cbourree/CFM---Mindstorms/Diapo/20151103_113038.jpg

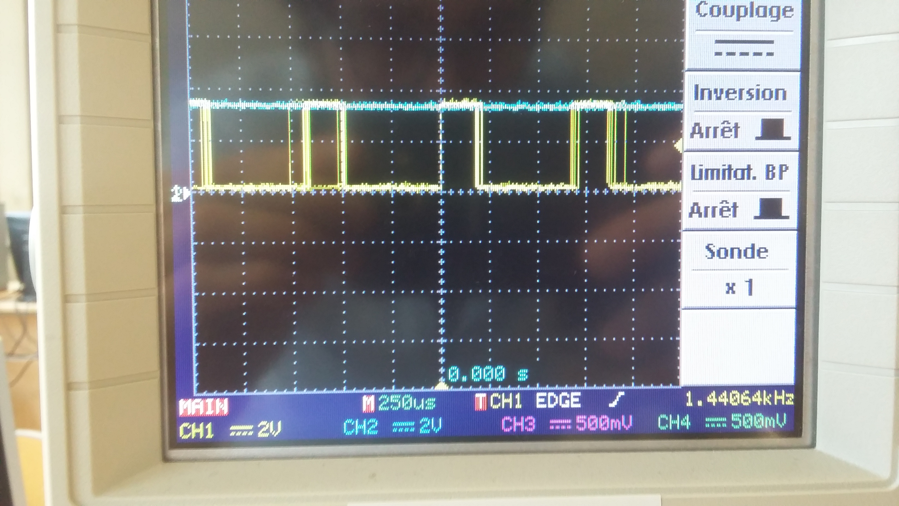
Diapo/20151103_113038.jpg
