cbourree/CFM---Mindstorms/Diapo/3D.png

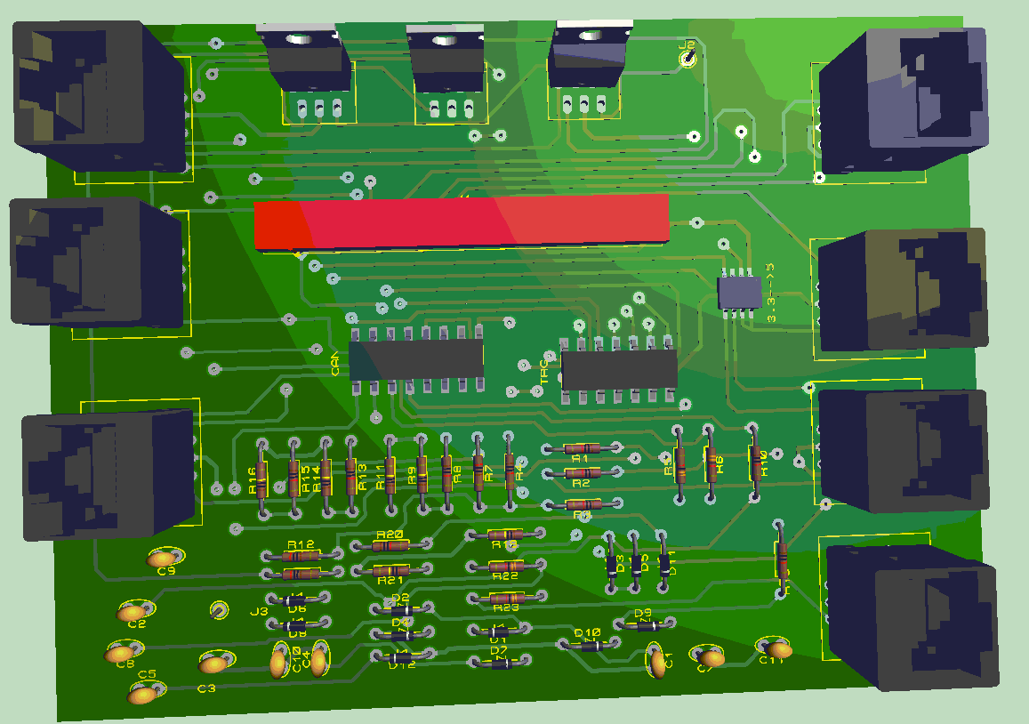
Diapo/3D.png
