cbourree/CFM---Mindstorms/Diapo/Présentaion1.pptx

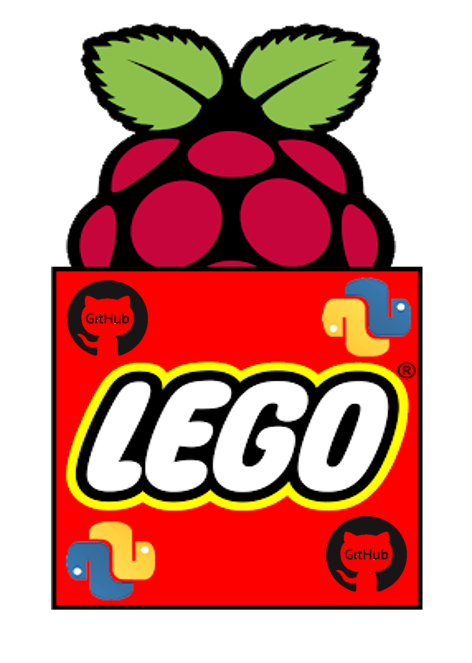
[picture p3: figure]

BERRYSTORM

PROST Maxime
BOURREE Charles ♥
SAGNOL Félix

## Slide 2

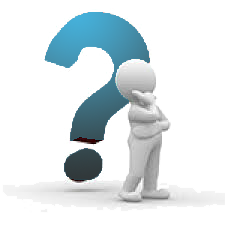
[picture p4: figure]

I – Présentation générale

II – Avancement

## Slide 3

I – Présentation générale

## Slide 4

Objectif

Remplacer le bloc de commande LEGO NXT par une carte programmable en Python fait à base d’une Raspberry PI.
+ Création d’une bibliothèque Python.
+ Faire un petit programme de démonstration.

## Slide 5

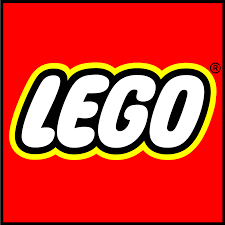
[picture p5: figure]
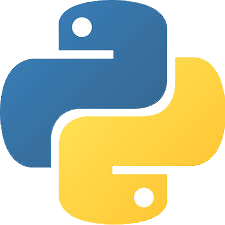
[picture p6: figure]
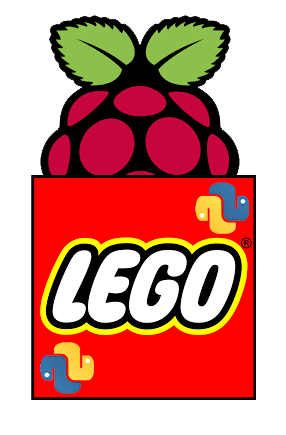
[picture p7: figure]
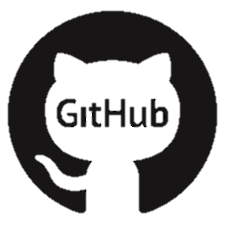
[picture p8: figure]
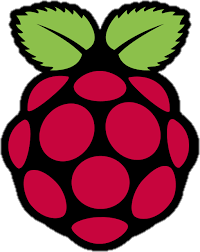
[picture p9: figure]

Outils utilisés

## Slide 6

Synoptique
capteurs digitaux

Raspberry

Réponse
numérique

CAN

Communication

5V

5V

Pont diviseur de tension

Réponse
analogique

Filtre

Réponse
analogique

Capteur digital

## Slide 7

Synoptique capteurs I²C

Raspberry

3,3 V <-> 5V
I²C

I²C

Réponse
numérique

CAN

5V

5V

I²C

Pont diviseur de tension

Réponse
analogique

Filtre

Réponse
analogique

Capteur I²C

## Slide 8

Synoptique moteur

Raspberry

Pont en H

9V

Batterie

Tension de
commande
PWM 3,3V

alimentation

3,3V

9V

Trigger

Moteur + Tachymètre

5V

Protection

5V

## Slide 9

II – Avancement

## Slide 10

GANTT

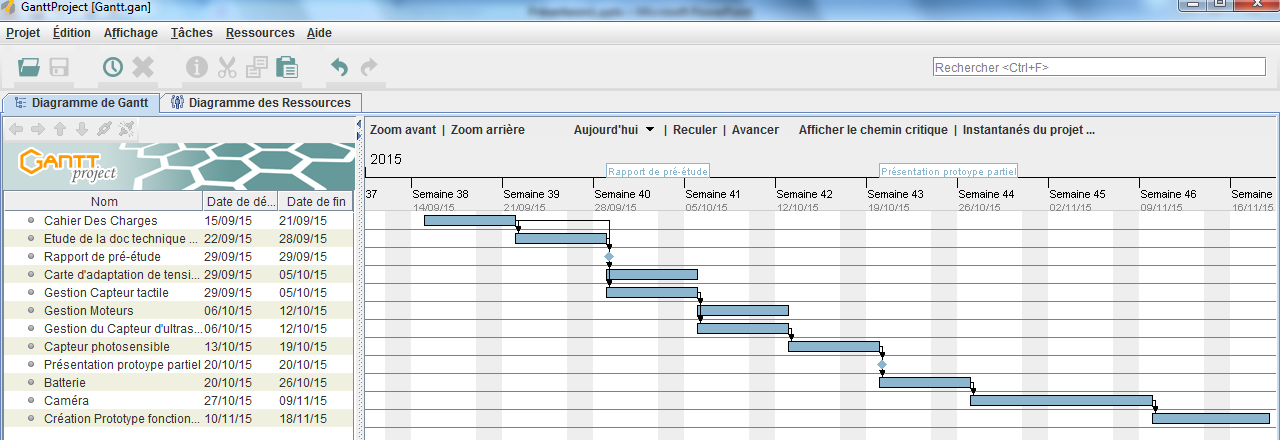
[picture p10: figure]

## Slide 11

FEUILLE DE COURSE

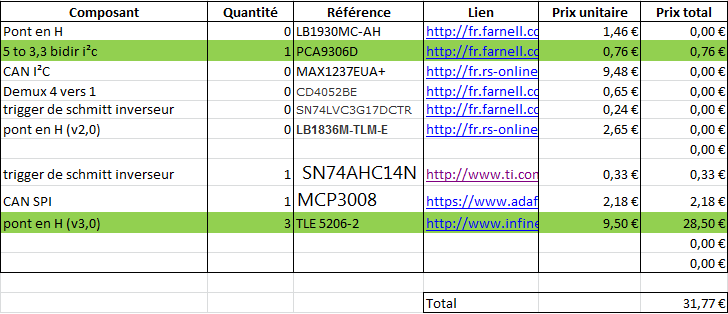
[picture p11: figure]

## Slide 12

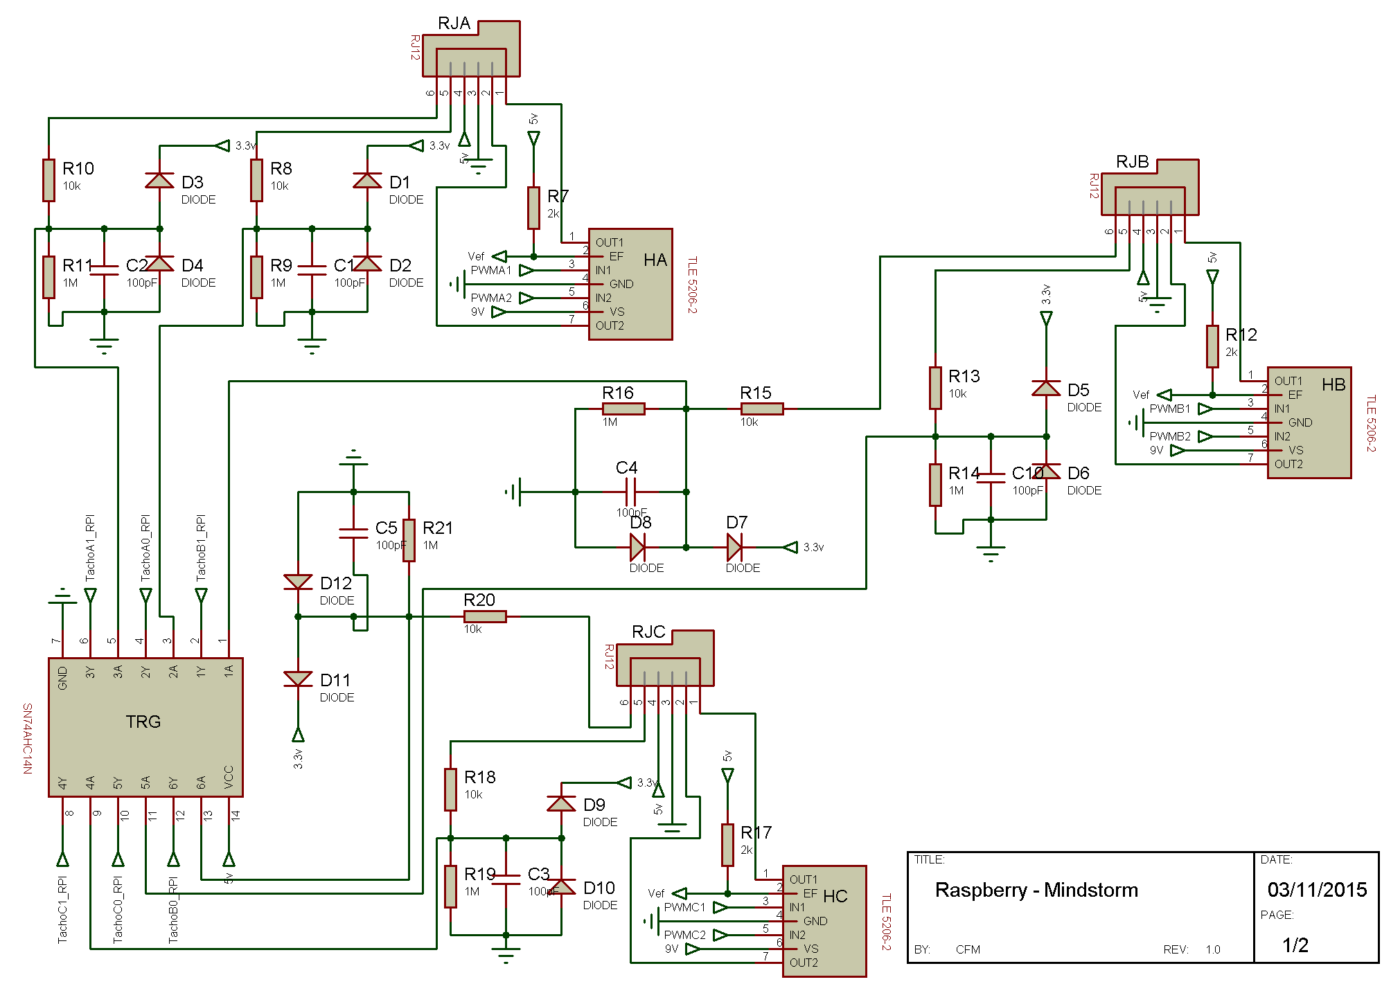
[picture p12: figure]

FEUILLE DE COURSE

## Slide 13

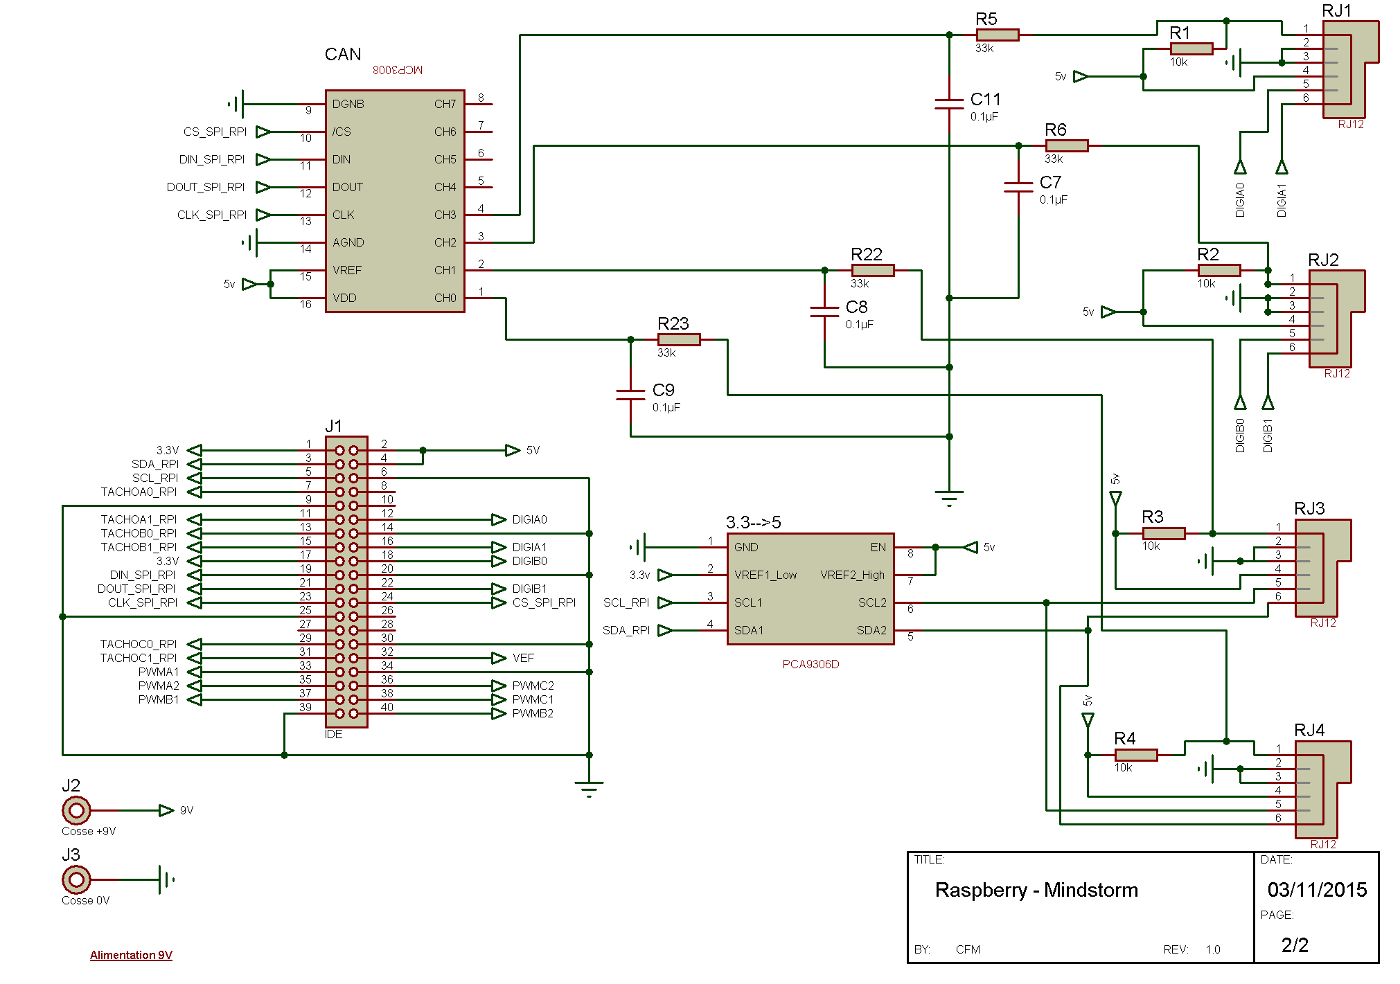
[picture p13: figure]

FEUILLE DE COURSE

## Slide 14

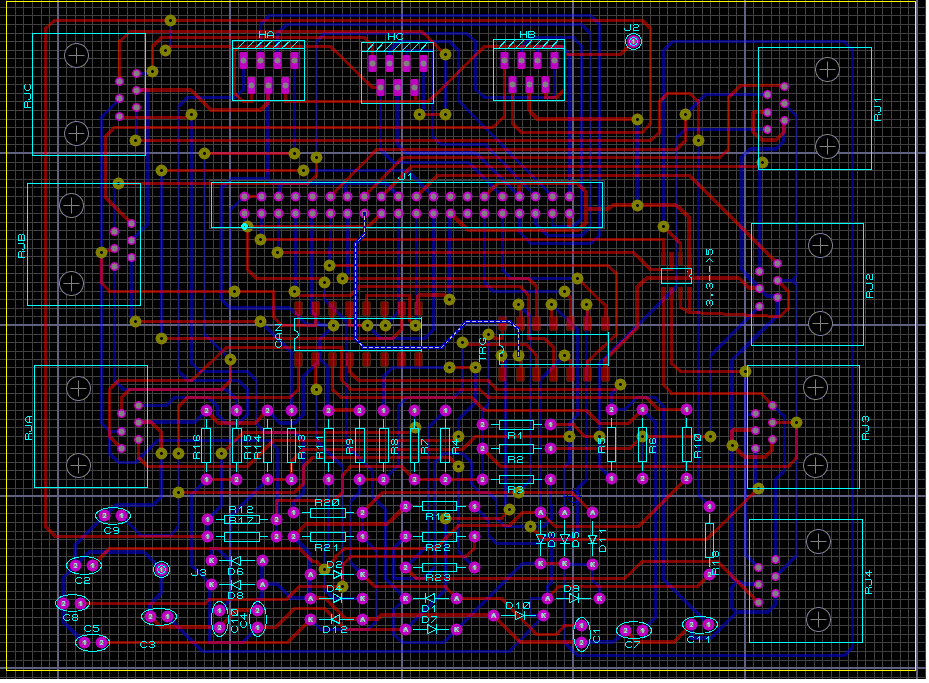
[picture p14: figure]

FEUILLE DE COURSE

## Slide 15


FEUILLE DE COURSE

## Slide 16

Suite des opérations

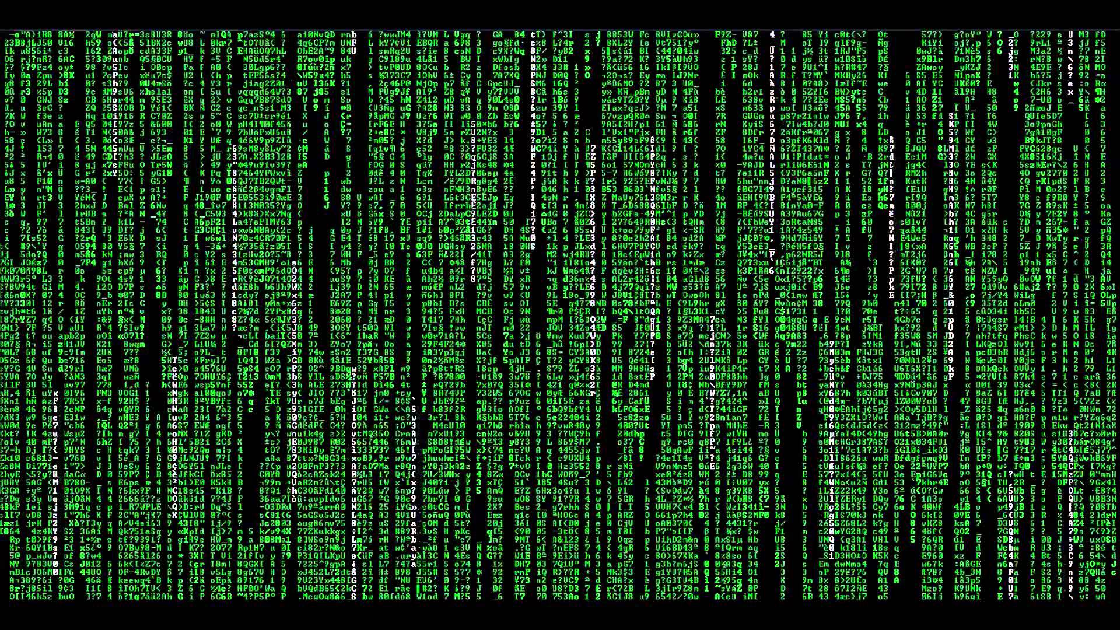
[picture p15: figure]

Programmation de la raspberry PI

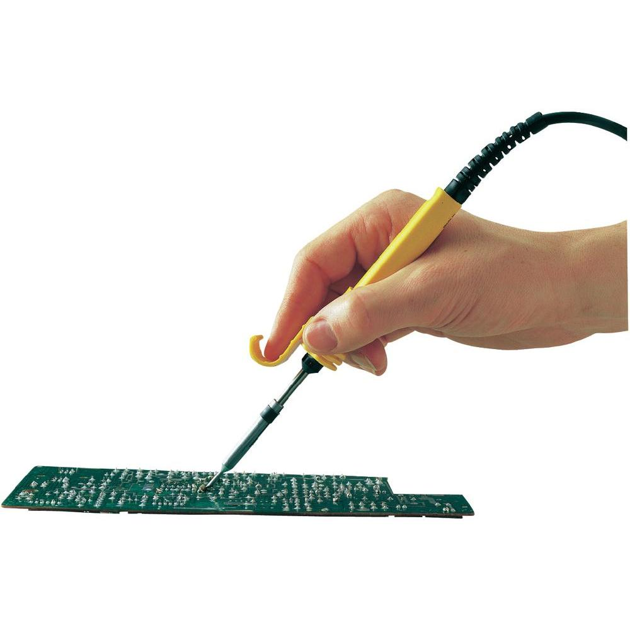
[picture p16: figure]

Soudure de la carte d’interfaçage
