cbourree/CFM---Mindstorms/Presentation/diagramme_charles.docx

Adaptation

Tension

Raspberry PI

Moteurs

Capteurs
