cbourree/CFM---Mindstorms/Presentation/SYNOPTIQUE-special-charles-pdf.pdf

CAPTEURS

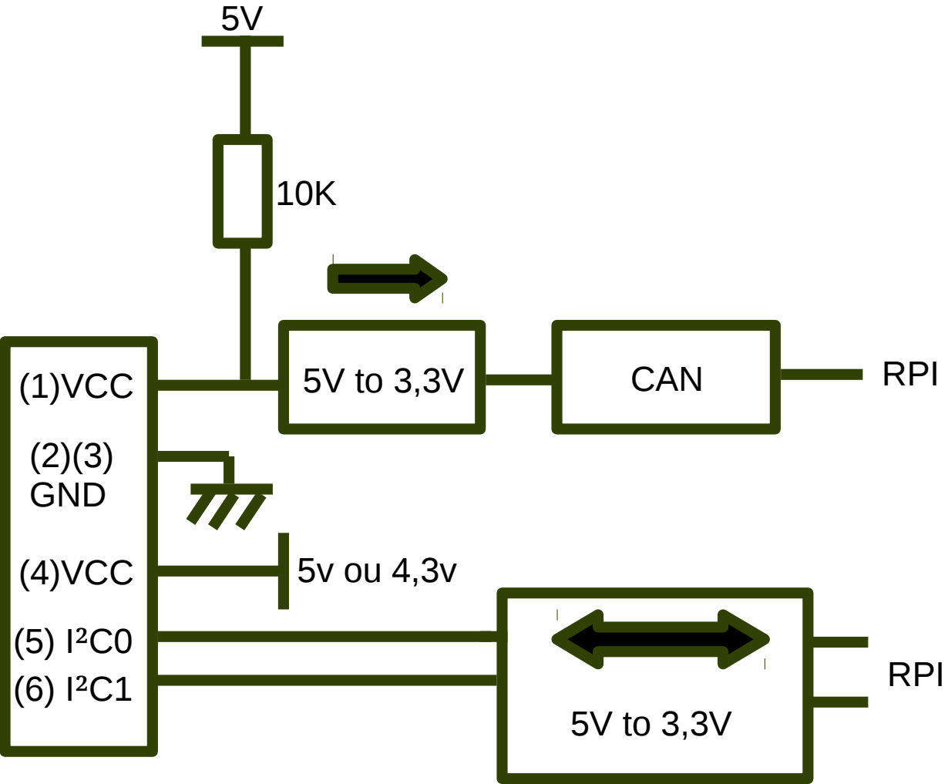
[picture p21: figure]
(1)VCC; (2)(3) GND; (4)VCC; (5) I²C0 (6) I²C1; RPI; CAN
