cbourree/CFM---Mindstorms/Diapo/20151103_113226.jpg

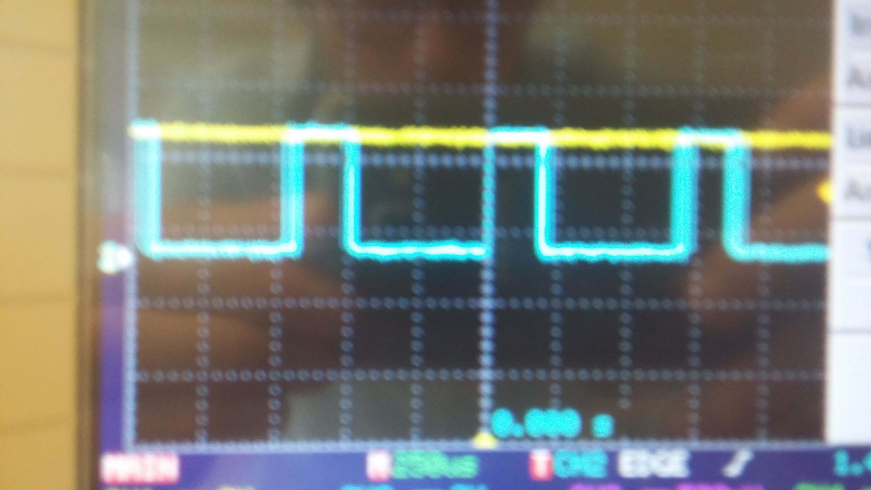
Diapo/20151103_113226.jpg
