cbourree/CFM---Mindstorms/Diapo/avancerpy.PNG

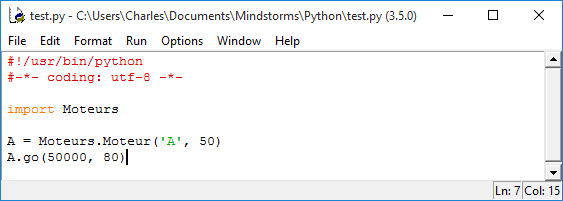
Diapo/avancerpy.PNG
