cbourree/CFM---Mindstorms/Documentation/moteur_fct.PNG

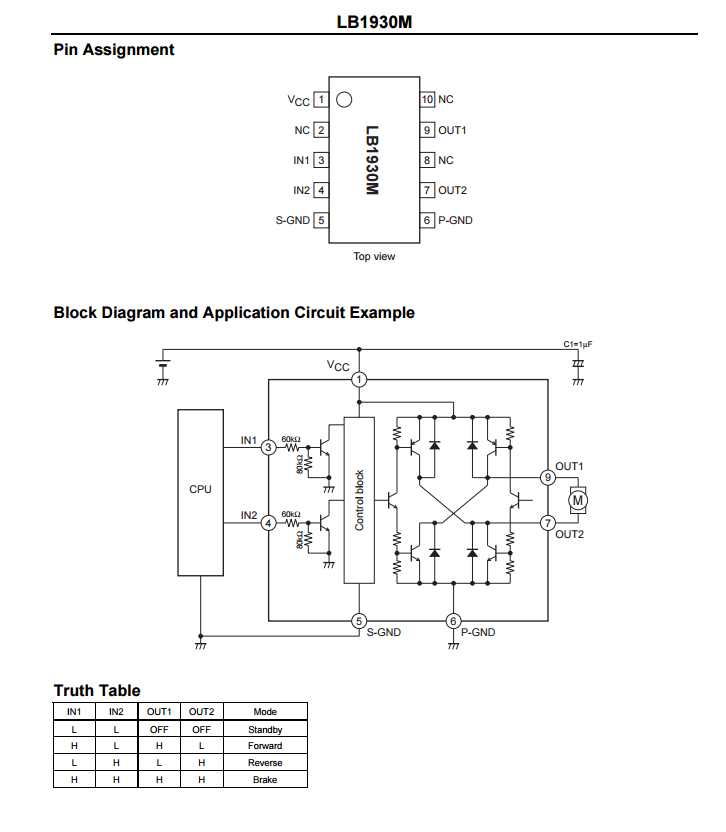
Documentation/moteur_fct.PNG
