cbourree/CFM---Mindstorms/Presentation/synoptiquegénérale.png

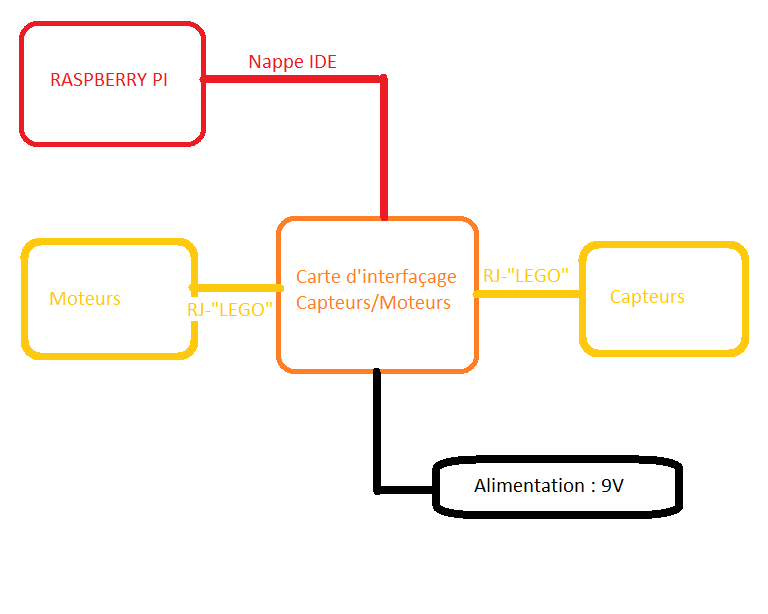
Presentation/synoptiquegénérale.png
