cbourree/CFM---Mindstorms/Presentation/feuille de course.xlsx

Composant | Quantité | Référence | Lien | Prix unitaire | Prix total
Pont en H | 0 | LB1930MC-AH | http://fr.farnell.com/on-semiconductor/lb1930mc-ah/motor-driver-dc-brush-1a-soic/dp/2458869 | 1.46 € | 0.00 €
5 to 3,3 bidir i²c | 1 | PCA9306D | http://fr.farnell.com/nxp/pca9306d/ic-i2c-smbus-volt-trans-double/dp/2212070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 | 0.76 € | 0.76 €
CAN I²C | 0 | MAX1237EUA+ | http://fr.rs-online.com/web/p/can-a-usage-general/7327670/?searchTerm=MAX1237EUA%2B&sra=p | 9.48 € | 0.00 €
Demux 4 vers 1 | 0 | CD4052BE | http://fr.farnell.com/texas-instruments/cd4052be/multiplexeur-demultiplexeur-4/dp/9589538 | 0.65 € | 0.00 €
trigger de schmitt inverseur | 0 | SN74LVC3G17DCTR | http://fr.farnell.com/texas-instruments/sn74lvc3g17dctr/circuit-logique-trigger-de-schmitt/dp/1236391 | 0.24 € | 0.00 €
pont en H (v2,0) | 0 | LB1836M-TLM-E | http://fr.rs-online.com/web/p/drivers-de-moteur/7570499/?searchTerm=LB1836M-TLM-E&sra=p | 2.65 € | 0.00 €
 |  |  |  |  | 0.00 €
trigger de schmitt inverseur | 1 | SN74AHC14N | http://www.ti.com/lit/ds/symlink/sn74ahc14.pdf | 0.33 € | 0.33 €
CAN SPI | 1 | MCP3008 | https://www.adafruit.com/datasheets/MCP3008.pdf | 2.18 € | 2.18 €
pont en H (v3,0) | 3 | TLE 5206-2 | http://www.infineon.com/dgdl/Infineon-TLE5206_2-DS-v01_01-en.pdf?fileId=db3a30431f848401011fc753a71779a7&ack=t | 9.50 € | 28.50 €
 |  |  |  |  | 0.00 €
 |  |  |  |  | 0.00 €
 |  |  | Total |  | 31.77 €
