cbourree/CFM---Mindstorms/(list of files, drawings)

Other design files:
schema.pdsprj
