cbourree/CFM---Mindstorms/(commit log)

2015-09-09 Ajout fichier cahier des charges
2015-09-22 1er schema isis
    [schema.pdsprj]
2015-09-27 Ajout du dbut de la notice d'utilisation, merci d'y faire un tour
2015-09-28 finilisatioon cdc+ ajout feuille courseé
    [feuille de course.xlsx]
2015-09-29 modification liste de course
    [feuille de course.xlsx]
2015-09-29 ajout 5 tio 3.3 i²c liste course
    [feuille de course.xlsx]
2015-09-29 update feuille de course
    [feuille de course.xlsx]
2015-09-29 Restruturation git + ajout demux à la liste des courses
    [feuille de course.xlsx]
2015-10-01 mise à jour nb de mux necessaire"
    [feuille de course.xlsx, schema.pdsprj]
2015-10-06 creation-library
    git commit -am creation-library
    [schema.pdsprj]
2015-10-06 creation max1237eua+
    [schema.pdsprj]
2015-10-06 update courses
    [feuille de course.xlsx, schema.pdsprj]
2015-10-06 mise a jour Library
    [schema.pdsprj]
2015-10-06 feuille de course
    [feuille de course.xlsx]
2015-10-07 mise a jour feuille de course
    [feuille de course.xlsx]
2015-10-08 debut schema
    [schema.pdsprj]
2015-10-13 Pont en H ares
    [schema.pdsprj]
2015-10-13 Ares 5 to 3.3*
    [feuille de course.xlsx, schema.pdsprj]
2015-10-13 Schema proteus
    [schema.pdsprj]
2015-10-15 Avancement et correction schema proteus isis
    [schema.pdsprj]
2015-10-15 Ajout tachoa1
    [schema.pdsprj]
2015-10-15 correction proteus hors cadre
    [schema.pdsprj]
2015-10-17 fin isis by charles
    [schema.pdsprj]
2015-10-20 ajout rpi proteus
    [schema.pdsprj]
2015-10-20 correction 9v
    [schema.pdsprj]
2015-10-20 proteus gg
    [schema.pdsprj]
2015-10-26 routage bordelique
    [schema.pdsprj]
2015-11-03 diapo presentation definitif
    [feuille de course.xlsx]
2015-11-03 pwm 1.1
2015-11-04 ajout pwm diapo
2015-11-12 Maj des fichiers des pythons
2015-11-14 Ajout Threads Moteurs et test moteurs
2015-11-17 Fonctionnement moteurs synchrone + CAN sur les 7 voies
2015-11-24 Ares fini !
    [schema.pdsprj]
2015-11-26 ajout nomenclature
    [schema.pdsprj]
